valkyriesavage/fluffy-toboggans/README

The Fluffy Toboggans : H2O IQ

A system for watering plants remotely: you don't have to worry about them!

Final presentation of this project : https://docs.google.com/presentation/d/1S5aFqThC5lc4pM-Y68lGRSMbOaRiJMXD9njBcWfeR2Q/edit

License: GPL v3
