valkyriesavage/fluffy-toboggans/SolidWorks/ft_board1109_osh_bottom_render.png

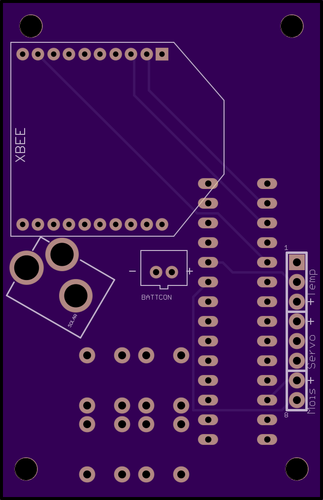
SolidWorks/ft_board1109_osh_bottom_render.png
