valkyriesavage/fluffy-toboggans/SolidWorks/ft_board1109_osh_top_render.png

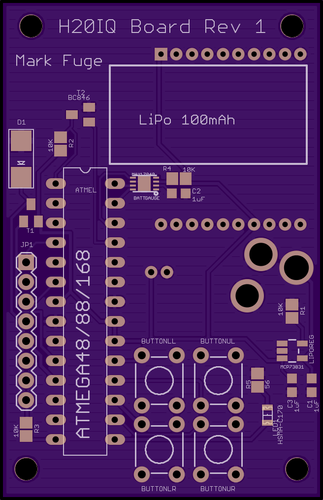
SolidWorks/ft_board1109_osh_top_render.png
