valkyriesavage/fluffy-toboggans/SolidWorks/xbee_top.png

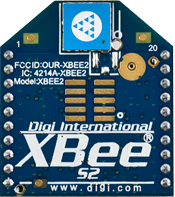
SolidWorks/xbee_top.png
