valkyriesavage/fluffy-toboggans/SolidWorks/casting_assembly.SLDASM

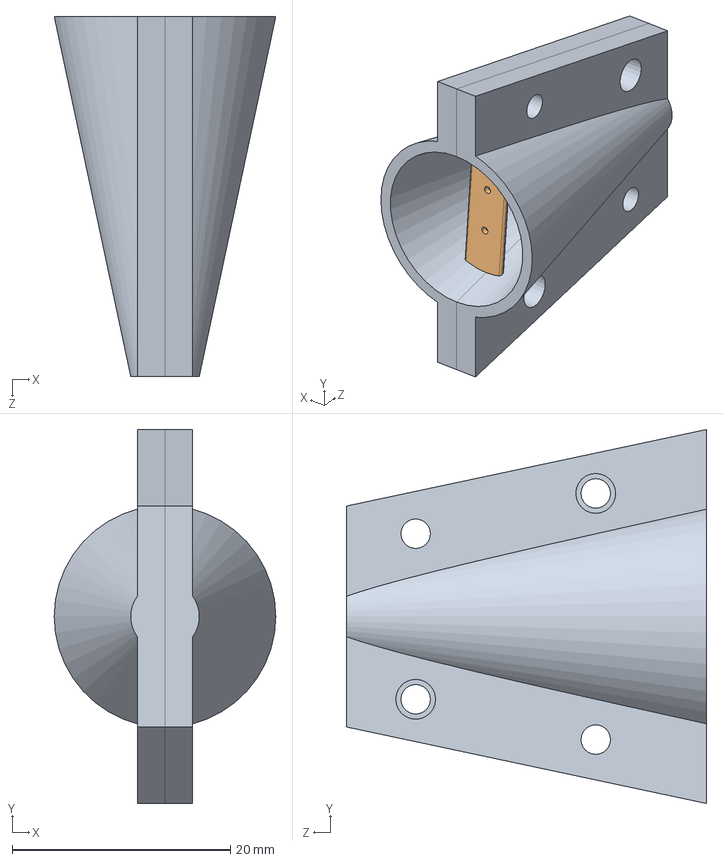
[picture p8: CAD file, 2012-12-04]
SolidWorks/casting_assembly.SLDASM
20.3 x 34.3 x 33.0 mm
sensor_cone x 2
top_nail_support
lower_nail_support
