valkyriesavage/fluffy-toboggans/SolidWorks/device_assembly.SLDASM

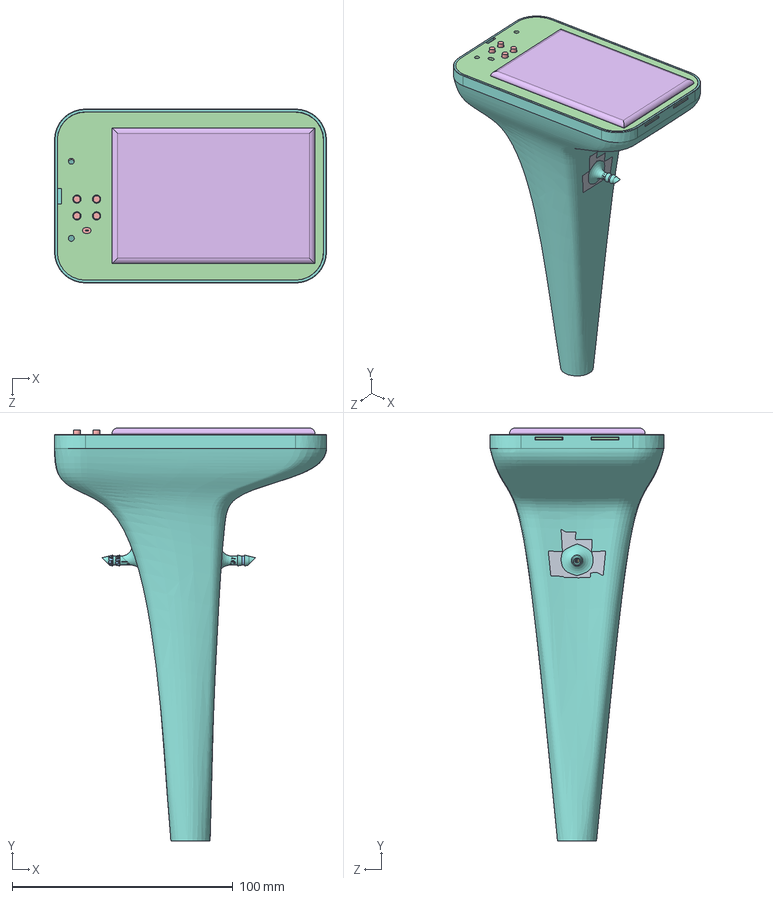
[picture p9: CAD file, 2012-11-26]
SolidWorks/device_assembly.SLDASM
123.2 x 187.0 x 78.7 mm
servo
lid
pcb
solar_cell
valve_insert
