valkyriesavage/fluffy-toboggans/SolidWorks/lower_nail_support.SLDPRT

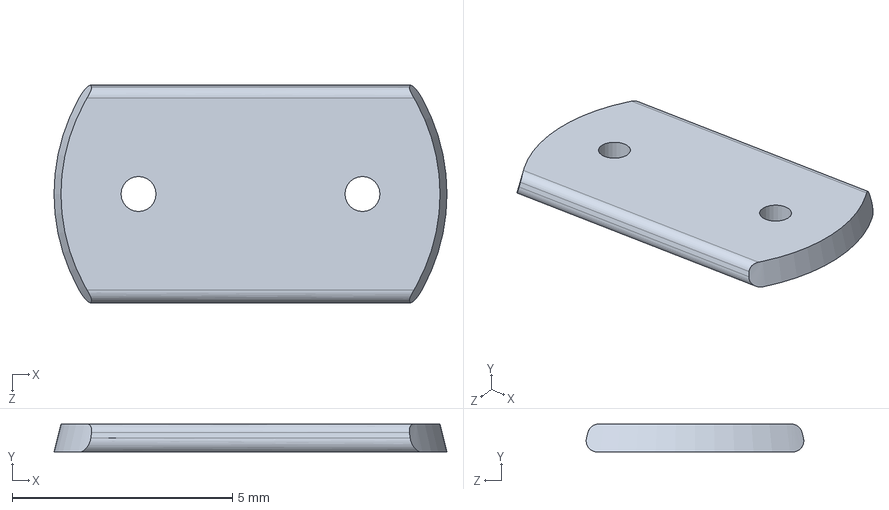
[picture p10: CAD file, 2012-12-04]
SolidWorks/lower_nail_support.SLDPRT
8.92 x 0.635 x 4.94 mm
