valkyriesavage/fluffy-toboggans/SolidWorks/sensor_cone.SLDPRT

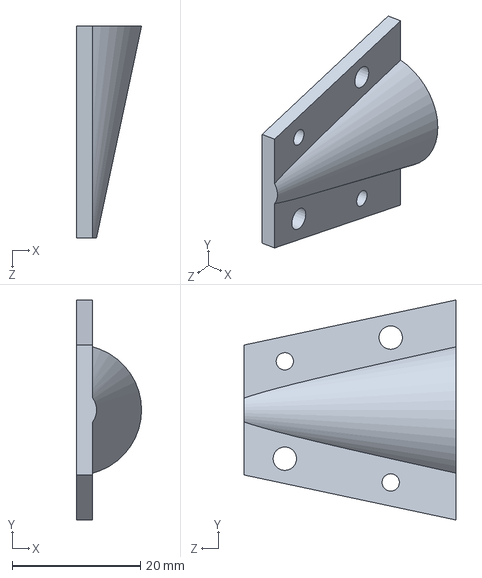
[picture p11: CAD file, 2012-12-04]
SolidWorks/sensor_cone.SLDPRT
10.2 x 34.3 x 33.0 mm
