valkyriesavage/fluffy-toboggans/SolidWorks/top_nail_support.SLDPRT

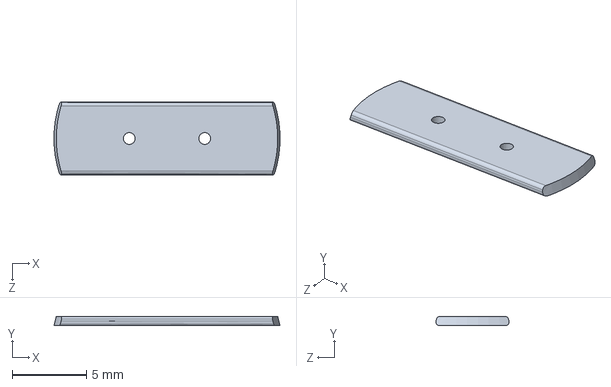
[picture p12: CAD file, 2012-12-04]
SolidWorks/top_nail_support.SLDPRT
15.2 x 0.635 x 4.94 mm
