valkyriesavage/fluffy-toboggans/SolidWorks/lid.SLDPRT

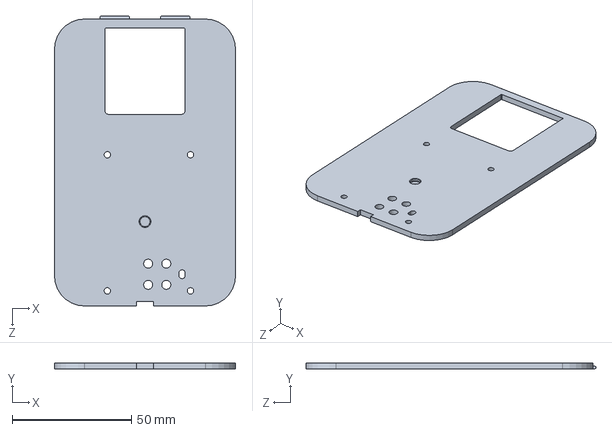
[picture p13: CAD file, 2012-11-26]
SolidWorks/lid.SLDPRT
76.1 x 2.54 x 121.8 mm
