valkyriesavage/fluffy-toboggans/SolidWorks/device_body_combined.sldprt

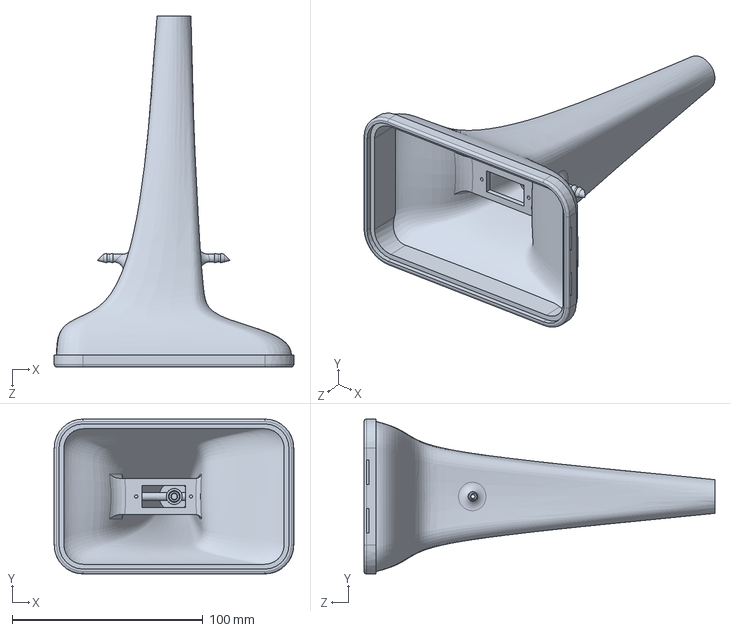
[picture p14: CAD file, 2012-11-19]
SolidWorks/device_body_combined.sldprt
125.7 x 81.3 x 184.2 mm
