valkyriesavage/fluffy-toboggans/SolidWorks/valve.SLDPRT

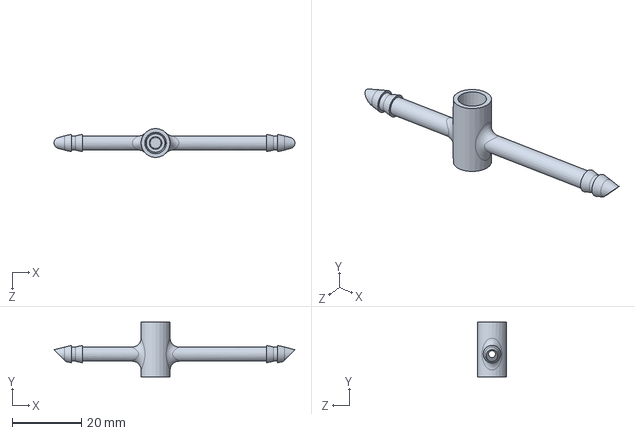
[picture p15: CAD file, 2012-11-19]
SolidWorks/valve.SLDPRT
69.6 x 15.9 x 8.38 mm
