valkyriesavage/fluffy-toboggans/SolidWorks/device.SLDPRT

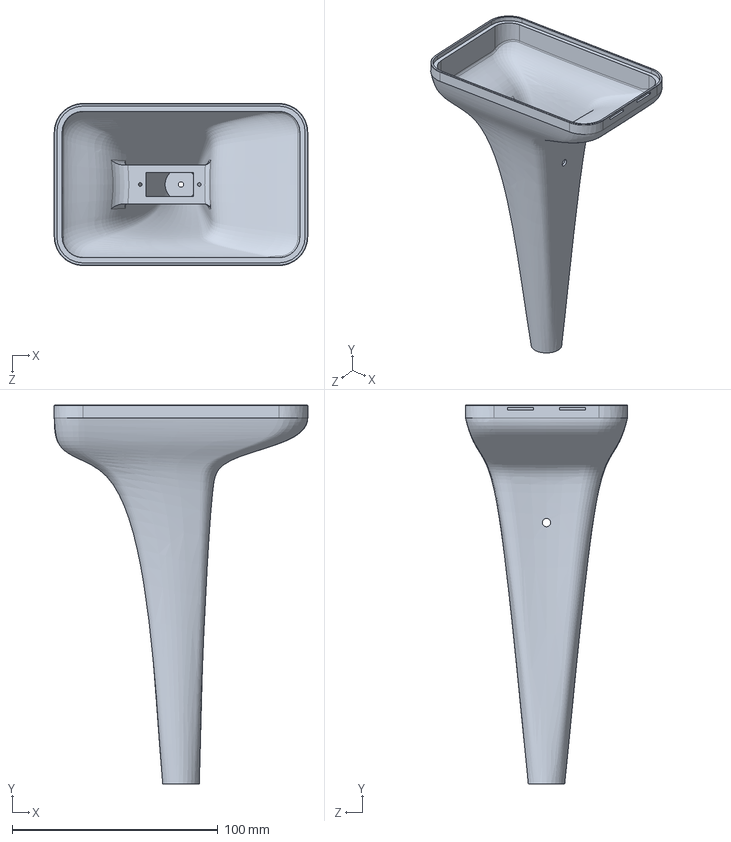
[picture p16: CAD file, 2012-11-19]
SolidWorks/device.SLDPRT
123.2 x 184.1 x 78.7 mm
