valkyriesavage/fluffy-toboggans/SolidWorks/valve_insert.SLDPRT

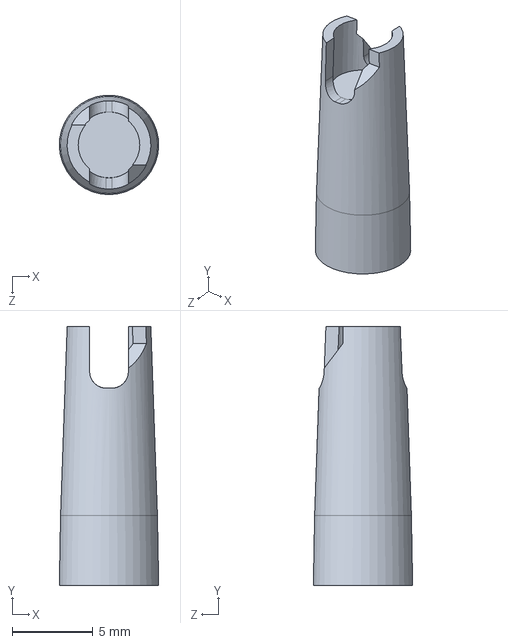
[picture p17: CAD file, 2012-11-19]
SolidWorks/valve_insert.SLDPRT
6.14 x 16.0 x 6.13 mm
