valkyriesavage/fluffy-toboggans/SolidWorks/servo.SLDPRT

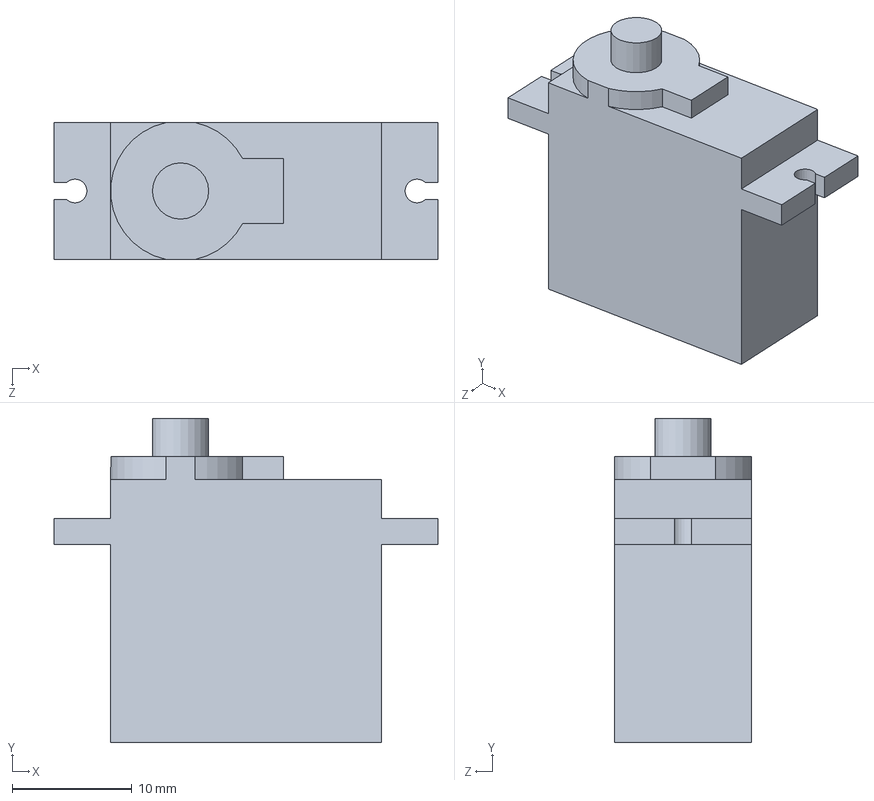
[picture p18: CAD file, 2012-11-14]
SolidWorks/servo.SLDPRT
32.1 x 27.1 x 11.4 mm
