valkyriesavage/fluffy-toboggans/SolidWorks/device_large_holes.SLDPRT

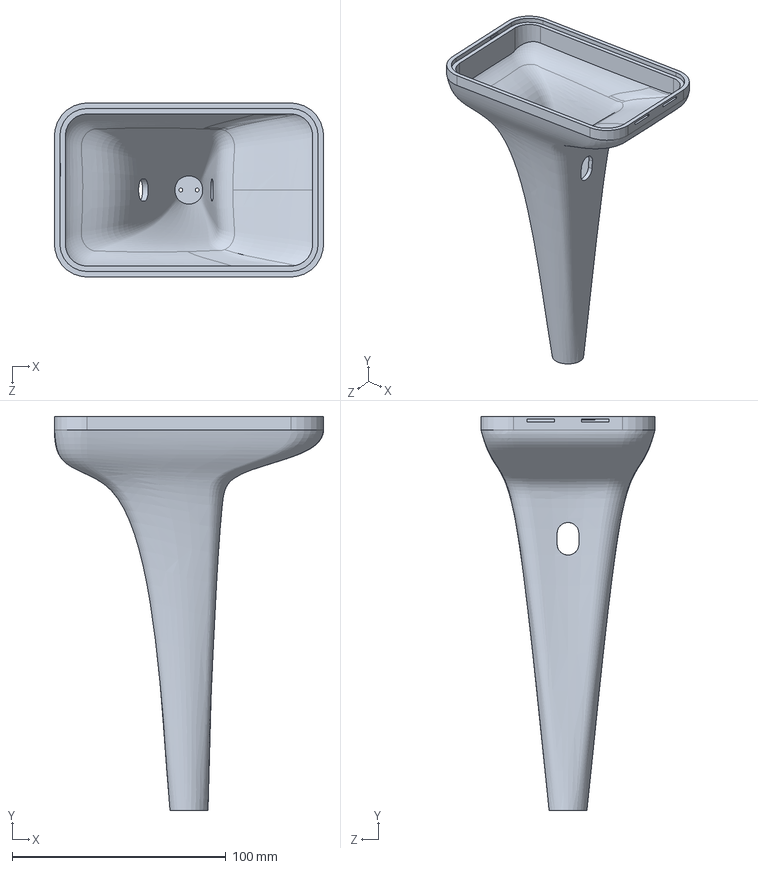
[picture p19: CAD file, 2012-11-14]
SolidWorks/device_large_holes.SLDPRT
125.7 x 184.1 x 81.3 mm
