valkyriesavage/fluffy-toboggans/SolidWorks/pcb.SLDPRT

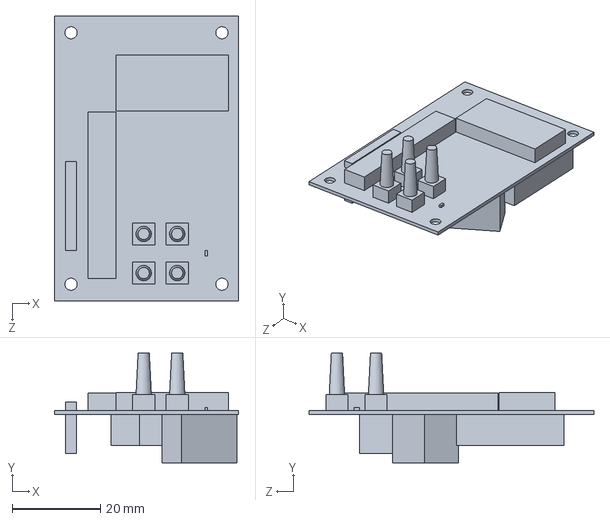
[picture p20: CAD file, 2012-11-13]
SolidWorks/pcb.SLDPRT
41.9 x 24.9 x 64.8 mm
