valkyriesavage/fluffy-toboggans/SolidWorks/solar_cell.SLDPRT

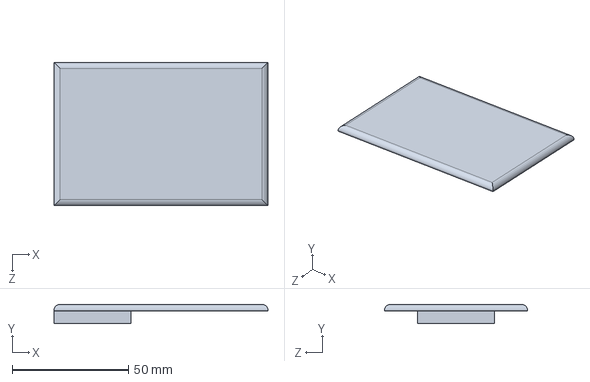
[picture p21: CAD file, 2012-11-13]
SolidWorks/solar_cell.SLDPRT
91.9 x 8.28 x 61.5 mm
