valkyriesavage/fluffy-toboggans/(list of files, cad)

Other CAD files:
SolidWorks/stl/casting_assembly.stl
SolidWorks/stl/device.stl
SolidWorks/stl/device_assembly.stl
SolidWorks/stl/device_body_combined.stl
SolidWorks/stl/device_large_holes.stl
SolidWorks/stl/lid.stl
SolidWorks/stl/lower_nail_support.stl
SolidWorks/stl/pcb.stl
SolidWorks/stl/sensor_cone.stl
SolidWorks/stl/servo.stl
SolidWorks/stl/solar_cell.stl
SolidWorks/stl/top_nail_support.stl
SolidWorks/stl/valve.stl
SolidWorks/stl/valve_insert.stl
