valkyriesavage/fluffy-toboggans/etc/Setup Guide.jpg

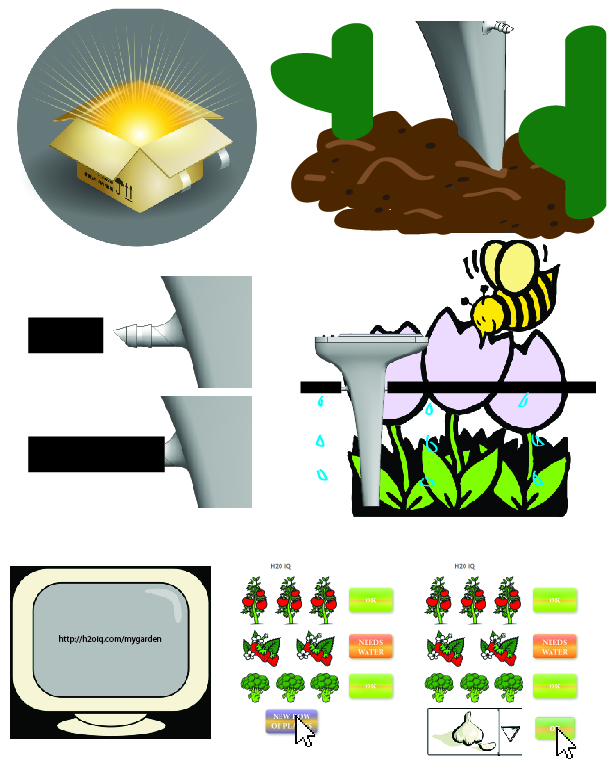
etc/Setup Guide.jpg
