valkyriesavage/fluffy-toboggans/eagle/h2oiq/h2oiq_rev2.brd

## EAGLE design eagle/h2oiq/h2oiq_rev2.brd (2012-12-04)

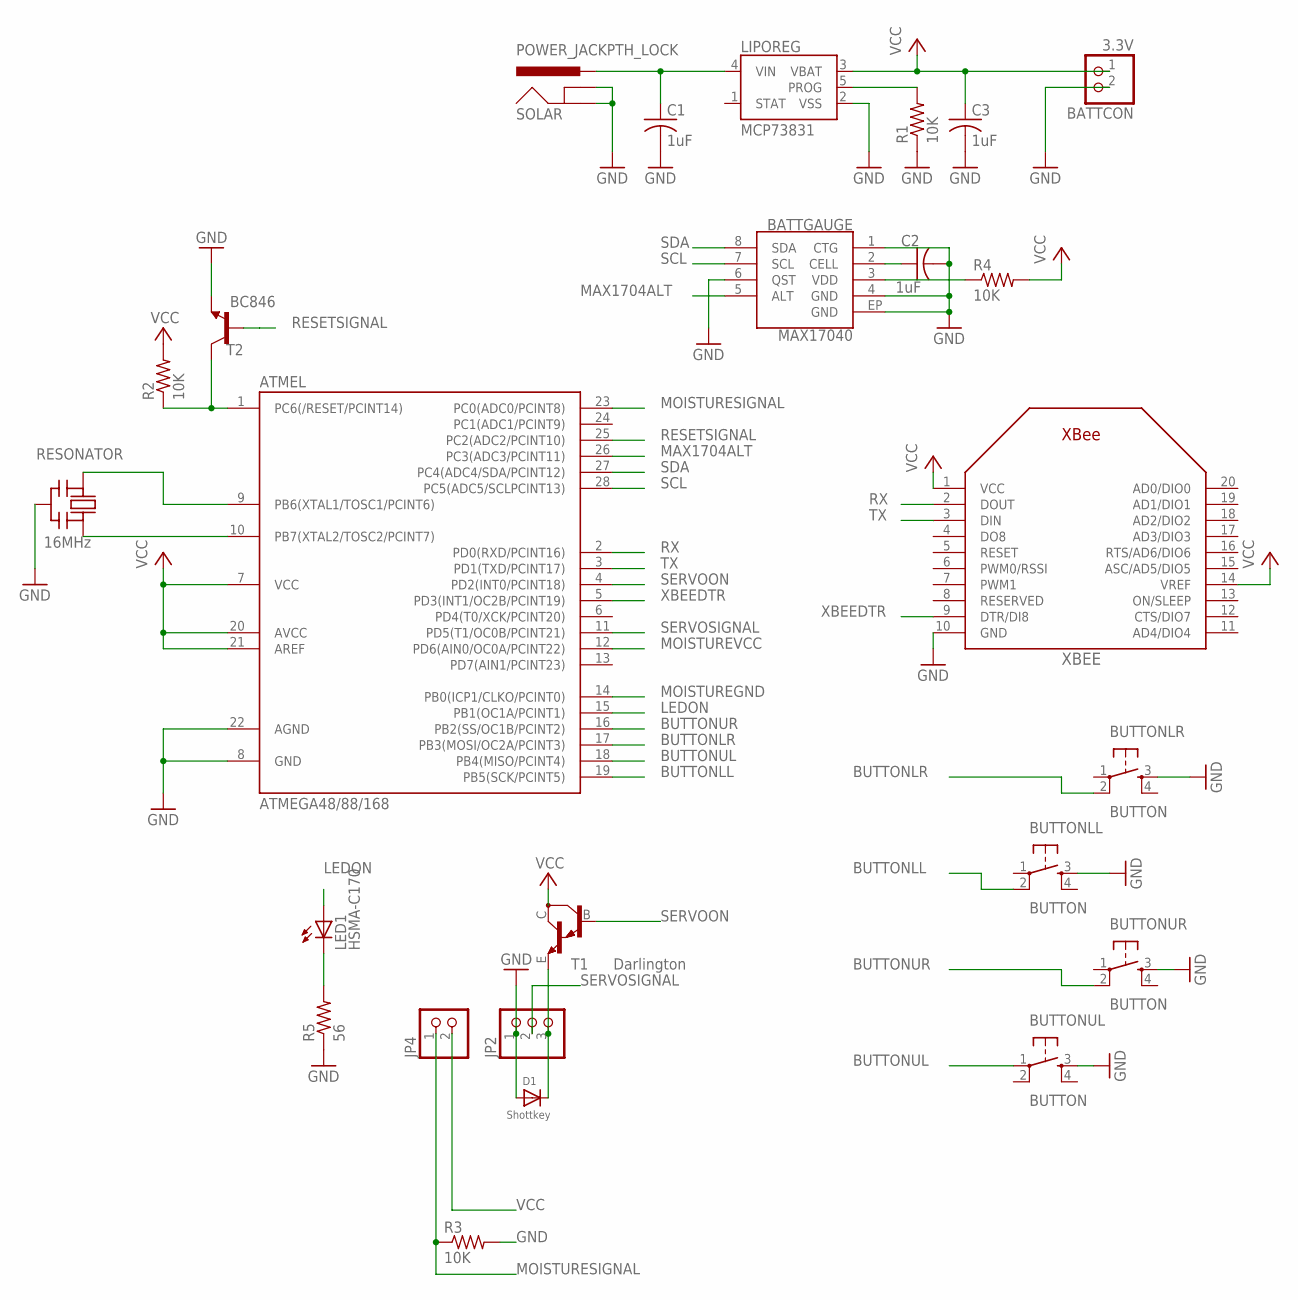
[picture p23: schematic h2oiq_rev2.sch]

Parts:
ATMEL: ATMEGA48/88/168; DIL28-3
BATTCON: 3.3V; JST-PH-2-THM
BATTGAUGE: MAX17040; MAX17040-TFDN
BUTTONLL: BUTTON; TACTILE-PTH
BUTTONLR: BUTTON; TACTILE-PTH
BUTTONUL: BUTTON; TACTILE-PTH
BUTTONUR: BUTTON; TACTILE-PTH
C1, C2, C3: 1uF; C0603K
D1: Shottkey; SMADIODE
JP2: PINHD-1X3; 1X03
JP4: PINHD-1X2; 1X02
LED1: HSMA-C170; LED-HSMA-SMD
LIPOREG: MCP73831; SOT23-5
R1, R2, R3, R4: 10K; R0805
R5: 56; R0805
RESONATOR: 16MHz; CERM_OSC
SOLAR: POWER_JACKPTH_LOCK; POWER_JACK_PTH_LOCK
T1: Darlington; SOT23-BEC
T2: BC846; SOT23
XBEE: XBEE

Connections:
BUTTONLL: ATMEL.19 (PB5(SCK/PCINT5)), BUTTONLL.2
BUTTONLR: ATMEL.17 (PB3(MOSI/OC2A/PCINT3)), BUTTONLR.2
BUTTONUL: ATMEL.18 (PB4(MISO/PCINT4)), BUTTONUL.1
BUTTONUR: ATMEL.16 (PB2(SS/OC1B/PCINT2)), BUTTONUR.2
GND: ATMEL.8 (GND), ATMEL.22 (AGND), BATTCON.2 (1), BATTGAUGE.1 (CTG), BATTGAUGE.4 (GND), BATTGAUGE.6 (QST), BATTGAUGE.EP (GND), BUTTONLL.3, BUTTONLR.3, BUTTONUL.3, BUTTONUR.3, C1.2, C2.2, C3.2, D1.A, JP2.1, LIPOREG.2 (VSS), R1.1, R3.2, R5.1, RESONATOR.P$2 (GND), SOLAR.GND, SOLAR.GNDBREAK, T2.2 (E), XBEE.10 (GND)
LEDON: ATMEL.15 (PB1(OC1A/PCINT1)), LED1.P$1 (A)
MAX1704ALT: ATMEL.26 (PC3(ADC3/PCINT11)), BATTGAUGE.5 (ALT)
MOISTUREGND: ATMEL.14 (PB0(ICP1/CLKO/PCINT0))
MOISTURESIGNAL: ATMEL.23 (PC0(ADC0/PCINT8)), JP4.1, R3.1
MOISTUREVCC: ATMEL.12 (PD6(AIN0/OC0A/PCINT22))
unnamed: BATTGAUGE.3 (VDD), R4.1
unnamed: LIPOREG.5 (PROG), R1.2
unnamed: ATMEL.1 (PC6(/RESET/PCINT14)), R2.1, T2.3 (C)
unnamed: ATMEL.10 (PB7(XTAL2/TOSC2/PCINT7)), RESONATOR.P$3 (OUT)
unnamed: ATMEL.9 (PB6(XTAL1/TOSC1/PCINT6)), RESONATOR.P$1 (IN)
unnamed: LED1.P$2 (C), R5.2
unnamed: BATTGAUGE.2 (CELL), C2.1
RESETSIGNAL: ATMEL.25 (PC2(ADC2/PCINT10)), T2.1 (B)
RX: ATMEL.2 (PD0(RXD/PCINT16)), XBEE.2 (DOUT)
SCL: ATMEL.28 (PC5(ADC5/SCLPCINT13)), BATTGAUGE.7 (SCL)
SDA: ATMEL.27 (PC4(ADC4/SDA/PCINT12)), BATTGAUGE.8 (SDA)
SERVOACT: D1.C, JP2.3, T1.E
SERVOON: ATMEL.4 (PD2(INT0/PCINT18)), T1.B
SERVOSIGNAL: ATMEL.11 (PD5(T1/OC0B/PCINT21)), JP2.2
TX: ATMEL.3 (PD1(TXD/PCINT17)), XBEE.3 (DIN)
VCC: ATMEL.7 (VCC), ATMEL.20 (AVCC), ATMEL.21 (AREF), BATTCON.1 (2), C3.1, JP4.2, LIPOREG.3 (VBAT), R2.2, R4.2, T1.C, XBEE.1 (VCC), XBEE.14 (VREF)
VIN: C1.1, LIPOREG.4 (VIN), SOLAR.PWR
XBEEDTR: ATMEL.5 (PD3(INT1/OC2B/PCINT19)), XBEE.9 (DTR/DI8)

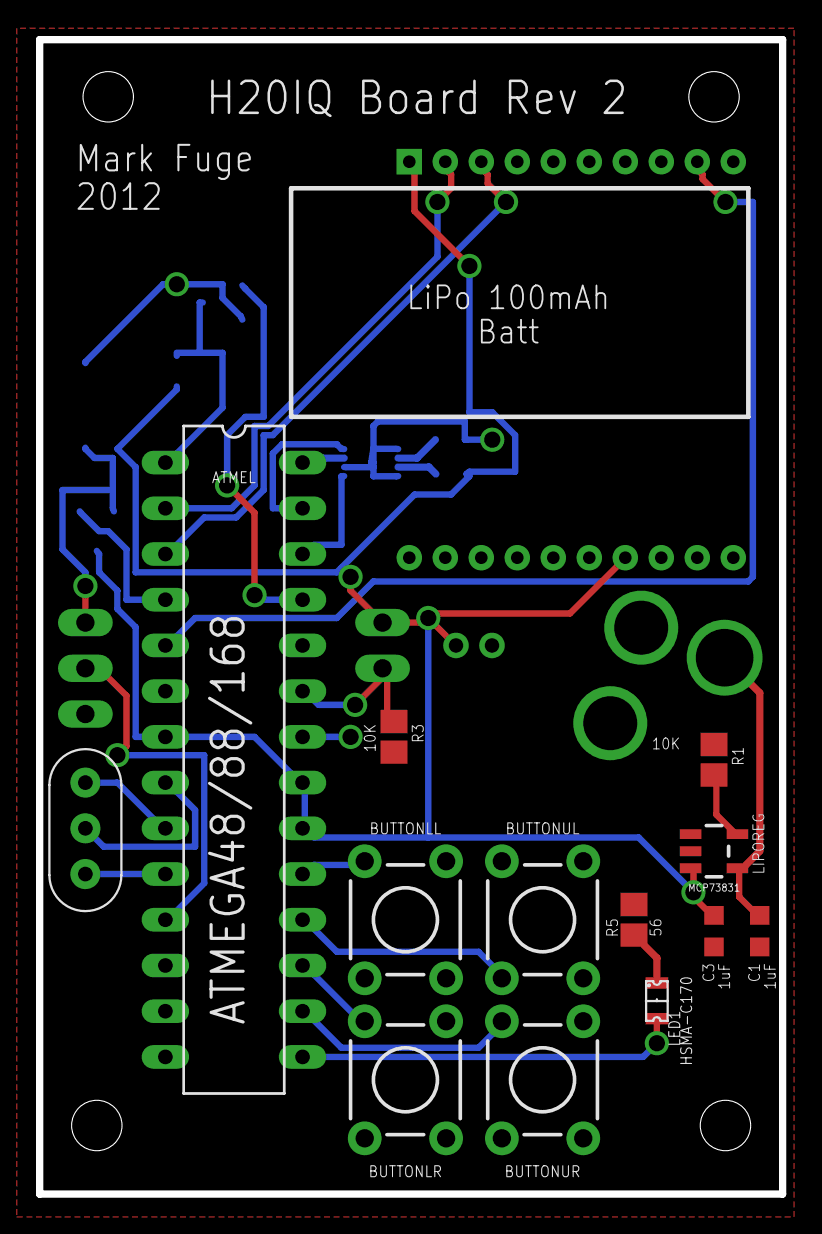
[picture p24: board h2oiq_rev2.brd from above]

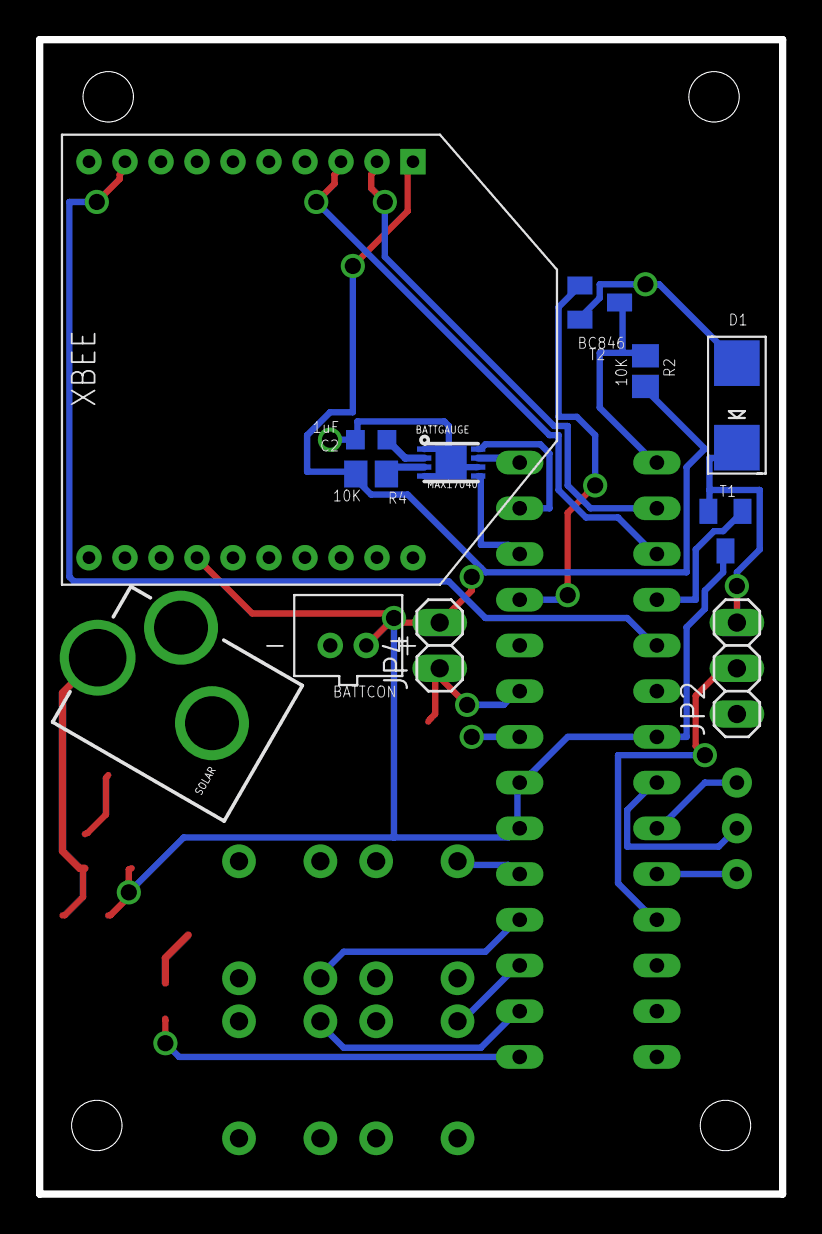
[picture p25: board h2oiq_rev2.brd from below]

Board: 2 copper layers, 41.3 x 64.1 mm, 25 parts (12 on the bottom side), 26 nets.
