valkyriesavage/fluffy-toboggans/eagle/h2oiq/prev_boards/h2oiq_v3.brd

## EAGLE design eagle/h2oiq/prev_boards/h2oiq_v3.brd (2012-11-07, an earlier design)

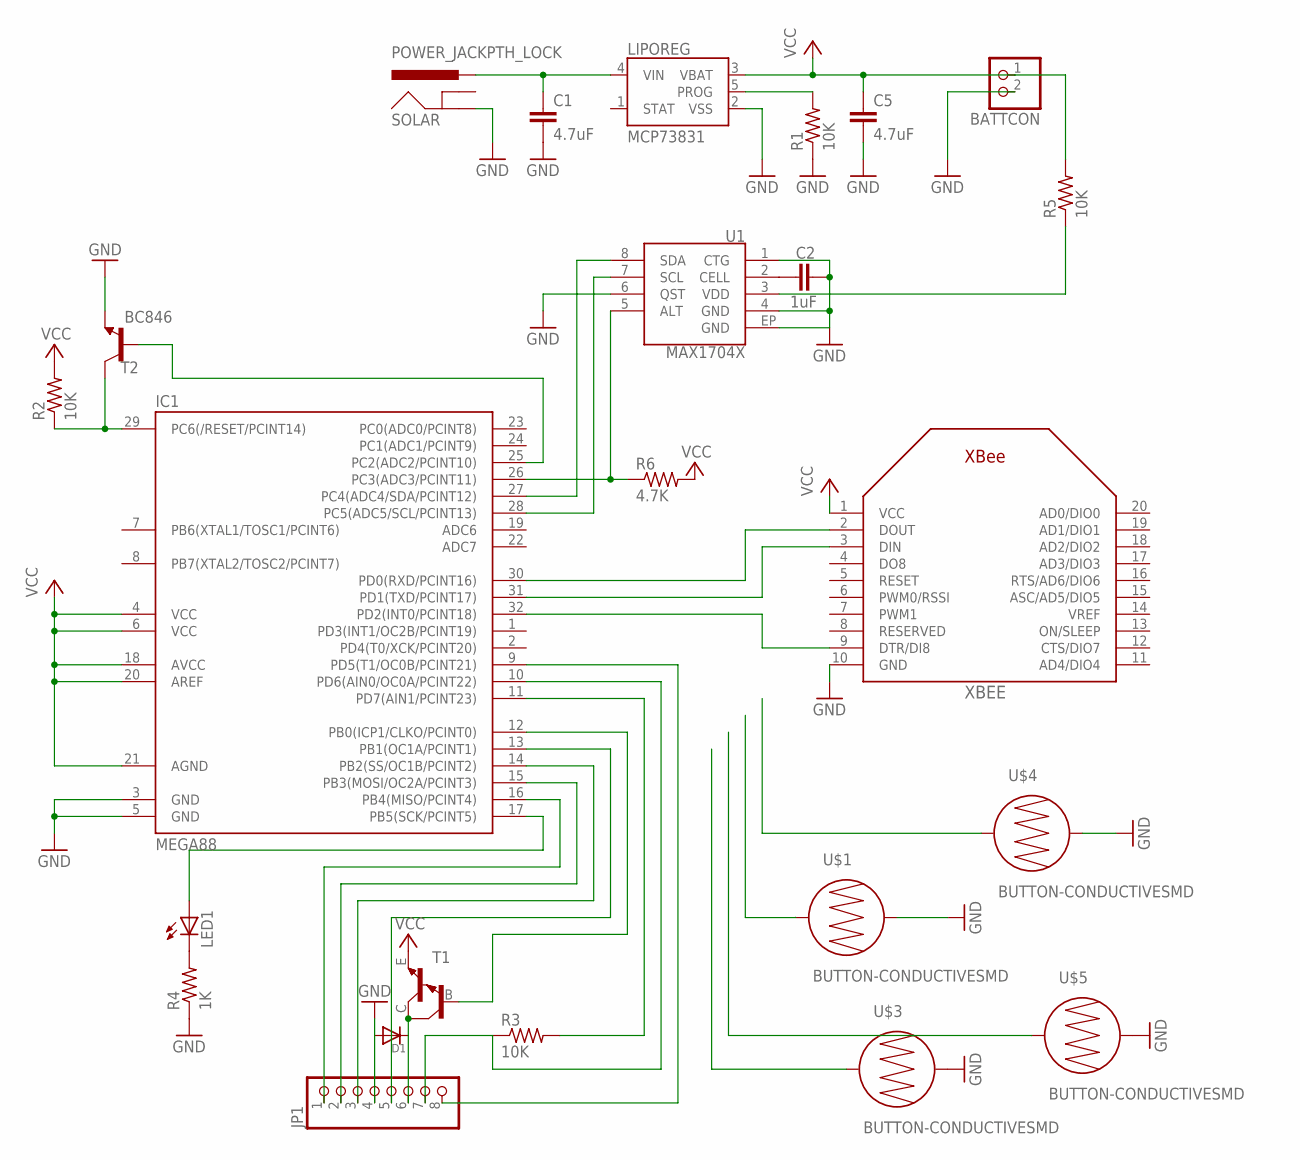
[picture p26: schematic h2oiq_v3.sch]

Parts:
BATTCON: JST_2PIN-SMT; JST-PH-2-SMT
C1, C5: 4.7uF; 0402-CAP
C2: 1uF; 0402-CAP
D1: DIODESMA; SMADIODE
IC1: MEGA88; MLF32
JP1: PINHD-1X8LOCK; 1X08-LOCK
LED1: LED3MM
LIPOREG: MCP73831; SOT23-5
R1, R3: 10K; R0603
R2, R5: 10K; R0603@1
R4: 1K; R0603@1
R6: 4.7K; R0603@1
SOLAR: POWER_JACKPTH_LOCK; POWER_JACK_PTH_LOCK
T1: MMBTA13LT1-NPN_DARL-SOT23-BEC; SOT23-BEC
T2: BC846; SOT23
U1: MAX1704X; TDFN-8
U$1, U$3, U$4, U$5: BUTTON-CONDUCTIVESMD; BUTTON-CONDUCTIVE
XBEE: XBEE

Connections:
AGND: IC1.21 (AGND)
GND: BATTCON.2 (1), C1.2, C2.2, C5.2, D1.A, IC1.3 (GND), IC1.5 (GND), JP1.4, LIPOREG.2 (VSS), R1.1, R4.1, SOLAR.GND, T2.2 (E), U1.1 (CTG), U1.4 (GND), U1.6 (QST), U1.EP (GND), U$1.2, U$3.2, U$4.2, U$5.2, XBEE.10 (GND)
unnamed: C1.1, LIPOREG.4 (VIN), SOLAR.PWR
unnamed: LIPOREG.5 (PROG), R1.2
unnamed: IC1.29 (PC6(/RESET/PCINT14)), R2.1, T2.3 (C)
unnamed: IC1.12 (PB0(ICP1/CLKO/PCINT0)), T1.B
unnamed: D1.C, JP1.6, T1.C
unnamed: IC1.27 (PC4(ADC4/SDA/PCINT12)), U1.8 (SDA)
unnamed: IC1.28 (PC5(ADC5/SCL/PCINT13)), U1.7 (SCL)
unnamed: IC1.32 (PD2(INT0/PCINT18)), XBEE.9 (DTR/DI8)
unnamed: IC1.15 (PB3(MOSI/OC2A/PCINT3)), JP1.2
unnamed: IC1.17 (PB5(SCK/PCINT5)), LED1.A
unnamed: LED1.K (C), R4.2
unnamed: IC1.14 (PB2(SS/OC1B/PCINT2)), JP1.3
unnamed: IC1.16 (PB4(MISO/PCINT4)), JP1.1
unnamed: IC1.10 (PD6(AIN0/OC0A/PCINT22)), JP1.7, R3.1
unnamed: IC1.26 (PC3(ADC3/PCINT11)), R6.1, U1.5 (ALT)
unnamed: IC1.30 (PD0(RXD/PCINT16)), XBEE.2 (DOUT)
unnamed: IC1.31 (PD1(TXD/PCINT17)), XBEE.3 (DIN)
unnamed: C2.1, U1.2 (CELL)
unnamed: R5.1, U1.3 (VDD)
unnamed: IC1.13 (PB1(OC1A/PCINT1)), JP1.5
unnamed: IC1.11 (PD7(AIN1/PCINT23)), R3.2
unnamed: IC1.9 (PD5(T1/OC0B/PCINT21)), JP1.8
unnamed: IC1.25 (PC2(ADC2/PCINT10)), T2.1 (B)
VCC: BATTCON.1 (2), C5.1, IC1.4 (VCC), IC1.6 (VCC), IC1.18 (AVCC), LIPOREG.3 (VBAT), R2.2, R5.2, R6.2, T1.E, XBEE.1 (VCC)

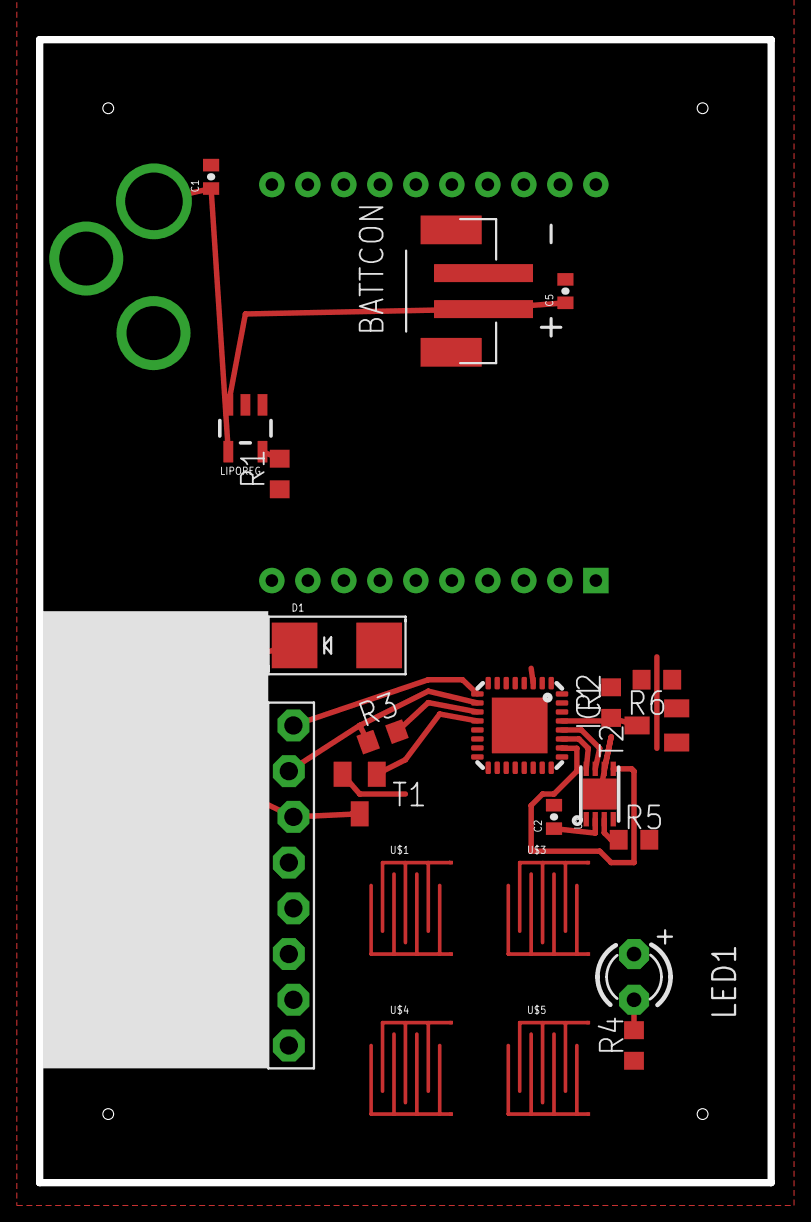
[picture p27: board h2oiq_v3.brd from above]

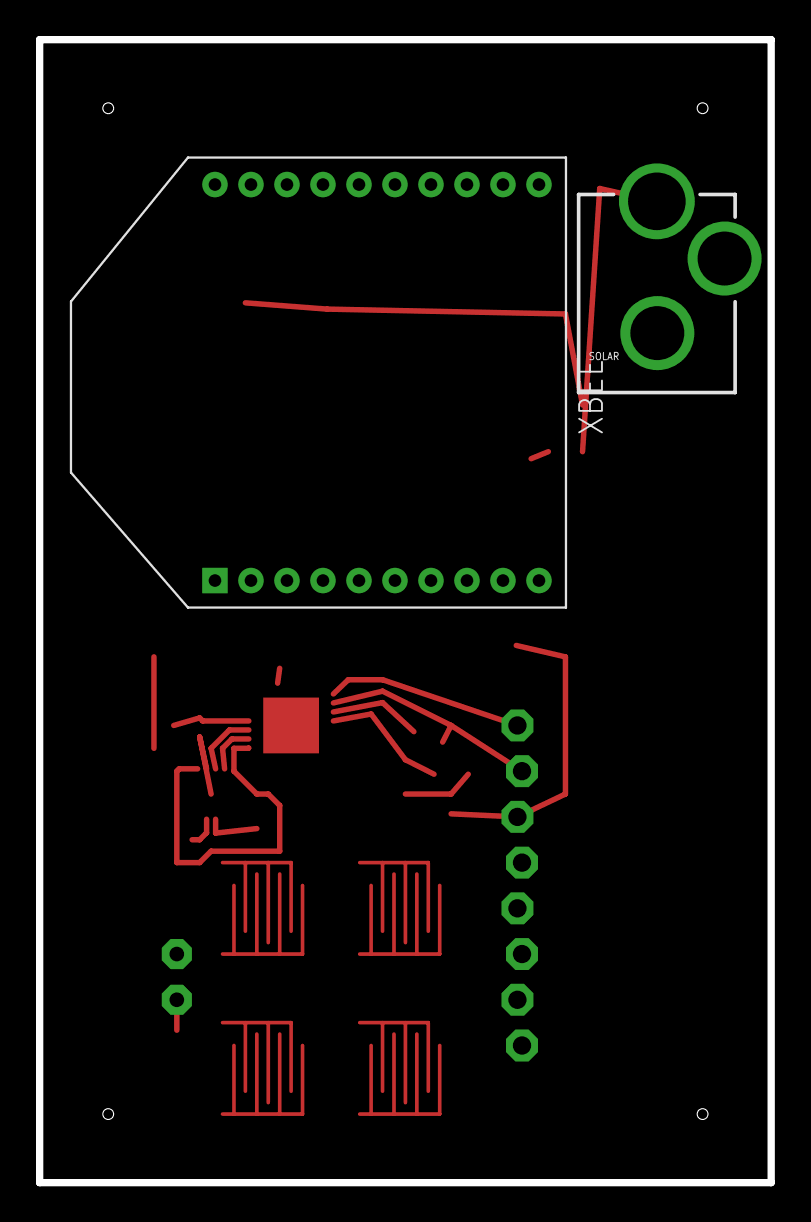
[picture p28: board h2oiq_v3.brd from below]

Board: 2 copper layers, 40.6 x 63.5 mm, 24 parts (2 on the bottom side), 25 nets.
