valkyriesavage/fluffy-toboggans/eagle/h2oiq/prev_boards/h2oiq.brd

## EAGLE design eagle/h2oiq/prev_boards/h2oiq.brd (2012-11-05, an earlier design)

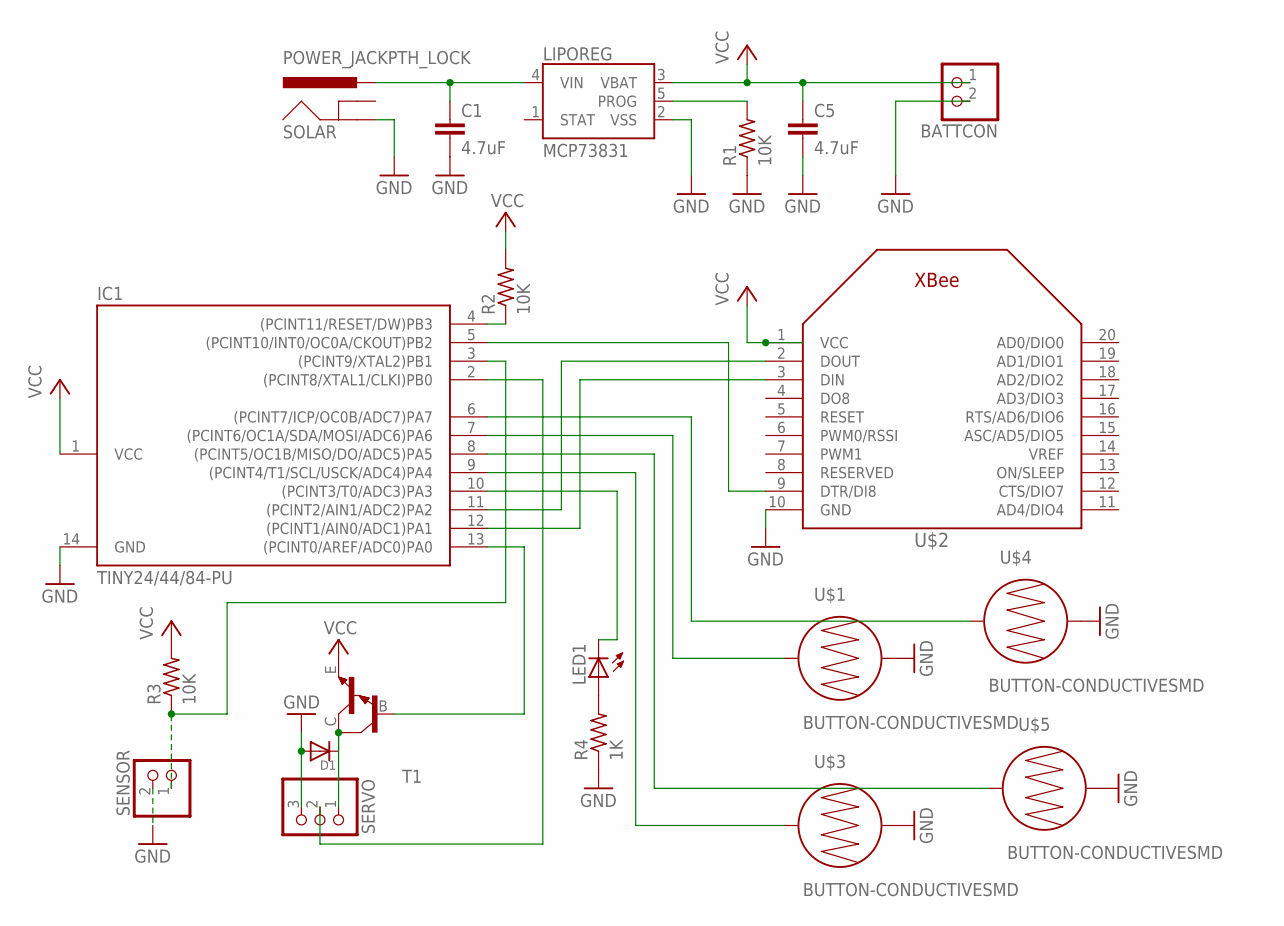
[picture p29: schematic h2oiq.sch]

Parts:
BATTCON: JST_2PIN-SMT; JST-PH-2-SMT
C1, C5: 4.7uF; 0402-CAP
D1: DIODESMA; SMADIODE
IC1: TINY24/44/84-PU; DIL14
LED1: LED5MM
LIPOREG: MCP73831; SOT23-5
R1, R2, R3: 10K; M1206
R4: 1K; M1206
SENSOR: JST_2PIN-SMT; JST-PH-2-SMT
SERVO: PINHD-1X3CB; 1X03-CLEANBIG
SOLAR: POWER_JACKPTH_LOCK; POWER_JACK_PTH_LOCK
T1: MMBTA13LT1-NPN_DARL-SOT23-BEC; SOT23-BEC
U$1, U$3, U$4, U$5: BUTTON-CONDUCTIVESMD; BUTTON-CONDUCTIVE
U$2: XBEE

Connections:
GND: BATTCON.2 (1), C1.2, C5.2, D1.A, IC1.14 (GND), LIPOREG.2 (VSS), R1.1, R4.1, SENSOR.2 (1), SERVO.3, SOLAR.GND, U$1.2, U$2.10 (GND), U$3.2, U$4.2, U$5.2
unnamed: C1.1, LIPOREG.4 (VIN), SOLAR.PWR
unnamed: LIPOREG.5 (PROG), R1.2
unnamed: IC1.4 ((PCINT11/RESET/DW)PB3), R2.1
unnamed: IC1.13 ((PCINT0/AREF/ADC0)PA0), T1.B
unnamed: D1.C, SERVO.1, T1.C
unnamed: IC1.5 ((PCINT10/INT0/OC0A/CKOUT)PB2), U$2.9 (DTR/DI8)
unnamed: IC1.11 ((PCINT2/AIN1/ADC2)PA2), U$2.2 (DOUT)
unnamed: IC1.12 ((PCINT1/AIN0/ADC1)PA1), U$2.3 (DIN)
unnamed: IC1.3 ((PCINT9/XTAL2)PB1), R3.1, SENSOR.1 (2)
unnamed: IC1.2 ((PCINT8/XTAL1/CLKI)PB0), SERVO.2
unnamed: LED1.A, R4.2
unnamed: IC1.10 ((PCINT3/T0/ADC3)PA3), LED1.K (C)
unnamed: IC1.7 ((PCINT6/OC1A/SDA/MOSI/ADC6)PA6), U$1.1
unnamed: IC1.6 ((PCINT7/ICP/OC0B/ADC7)PA7), U$4.1
unnamed: IC1.8 ((PCINT5/OC1B/MISO/DO/ADC5)PA5), U$5.1
unnamed: IC1.9 ((PCINT4/T1/SCL/USCK/ADC4)PA4), U$3.1
VCC: BATTCON.1 (2), C5.1, IC1.1 (VCC), LIPOREG.3 (VBAT), R2.2, R3.2, T1.E, U$2.1 (VCC)

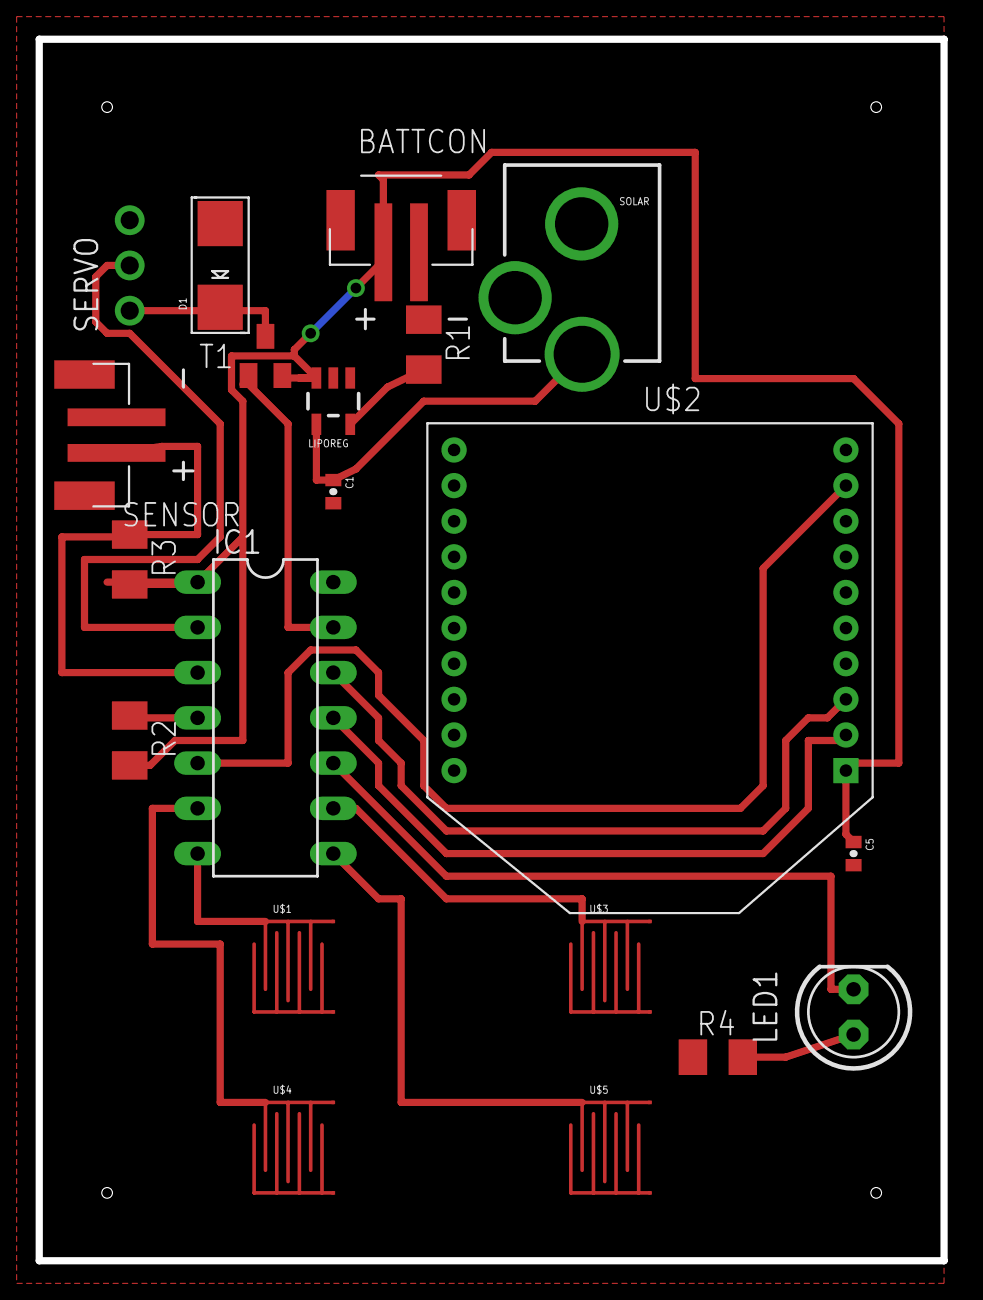
[picture p30: board h2oiq.brd from above]

Board: 2 copper layers, 50.8 x 68.6 mm, 20 parts (0 on the bottom side), 18 nets.
