valkyriesavage/fluffy-toboggans/(commit log)

2012-10-29 revising the device design
    [device.SLDPRT]
2012-10-30 more updates to device physical design
    [device.SLDPRT]
2012-10-30 allow valve insertion
    [device.SLDPRT]
2012-11-05 Adding gitignore and Eagle files
    [h2oiq.brd, h2oiq.sch, h2oiq_v2.brd, h2oiq_v2.sch]
2012-11-07 New PCB board designs
    [h2oiq_v3.brd, h2oiq_v3.sch, h2oiq_v4.brd, h2oiq_v4.sch]
2012-11-07 minor pcb change
    [h2oiq_v4.brd]
2012-11-08 New board adjustments
    [h2oiq_v4.brd, h2oiq_v4.sch]
2012-11-08 Adding PCB solidworks file
    [pcb.SLDPRT]
2012-11-08 updates to part
    [device.SLDPRT]
2012-11-08 new sexy device body
    [devicer2.SLDPRT]
2012-11-08 version 2 of parts, ready to go but for lid adjustments
    [devicer2.SLDPRT, lid.SLDPRT]
2012-11-08 updated PCB part file with XBee, Power Jack, and LED
    [pcb.SLDPRT]
2012-11-09 First complete revision of the H2OIQ board. Sent to OSH Park for production
    [h2oiq.brd, h2oiq.sch, h2oiq_rev1.brd, h2oiq_rev1.sch, h2oiq_v2.brd, h2oiq_v2.sch, h2oiq_v3.brd, h2oiq_v3.sch]
2012-11-09 Finished the PCB Rev1 part
    [pcb.SLDPRT]
2012-11-09 yay, updates!
    [device.SLDPRT, devicer2.SLDPRT, lid.SLDPRT]
2012-11-10 Adding HiTec 55 servo part
    [servo.SLDPRT]
2012-11-10 Adding first attempt at valve part
    [valve.SLDPRT]
2012-11-13 Initial shot at the SolidWorks assembly. Still need to create second valve piece for servo and to figure out valve to device attachment mechanism. Need to incorporate Valkyrie's servo mount feature i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
    [device.SLDPRT, device_assembly.SLDASM, lid.SLDPRT, pcb.SLDPRT, solar_cell.SLDPRT, valve.SLDPRT]
2012-11-14 Rev 1 of Solidworks parts and assembly. Current version would be ok for 3D printing, but not for injection molding
    [device.SLDPRT, device_assembly.SLDASM, device_large_holes.SLDPRT, lid.SLDPRT, servo.SLDPRT, valve.SLDPRT, valve_insert.SLDPRT]
2012-11-15 server architecture for raspberry pi
    * forked from Tinaja Labs repository, based partiall on Tornado
    example code
    * this is the basic server, nearly all functional
    * gitignore updates for pyc files
2012-11-15 Streamlining and updating
    * removing all test files we don't need
    * moved readme.md to README so it's more obvious
    * allsensors.py now does only what we need it to
    * server.py now can read sensor data files
2012-11-16 now the datetime actually appears on the x axis
2012-11-19 Added tolerance adjustments for 3D printing for v2 of device
    [device.SLDPRT, device_assembly.SLDASM, lid.SLDPRT, valve.SLDPRT, valve_insert.SLDPRT]
2012-11-19 Adding combined body
    [device_body_combined.sldprt, device_body_combined.stl]
2012-11-21 Changing the lid part to deal with some 3D printer cracking issues
    [device_assembly.SLDASM, lid.SLDPRT]
2012-11-27 protocol agreements
    * now sending chars to xbee for use at device
    * now sending newlines back in response to moisture readings
    * now touching files to make sure they exist
2012-11-28 testing and fixes
    * this now actually works ;)
    [server.py]
2012-11-28 Adding LPFK board files for printing, because OSH Park completely dropped the ball on our earlier PCB order.
    [h2oiq_rev2.brd, h2oiq_rev2.sch]
2012-11-29 adding arduino code
2012-11-29 Minor board change for the LPFK
    [h2oiq_rev2.brd, h2oiq_rev2.sch]
2012-12-01 sensor updates now show live in chart
    * removed some crufty stuff from html files
    * renamed/reworked auto water form to make sense to the server
    * fixed update function in js
    * fixed new data send function in server
    [allsensors.py, server.py]
2012-12-02 reverting the logic in auto mode back to what the arduino code expects - first comes the high moisture threshold, then the high one.
2012-12-03 adding images for the plant and the device
2012-12-04 Adding Demo Arduino Code, as well as updated board changes
    [h2oiq_rev2.brd, h2oiq_rev2.sch]
2012-12-04 Adding Solidworks parts for the sensor casting assembly
    [casting_assembly.SLDASM, lower_nail_support.SLDPRT, sensor_cone.SLDPRT, top_nail_support.SLDPRT]
2014-11-13 added files in stl format
    [casting_assembly.stl, device.stl, device_assembly.stl, device_body_combined.stl, device_large_holes.stl, lid.stl, lower_nail_support.stl, pcb.stl]
